ninocity31/Smart-Street-Lighting-LoRa/(commit log)

2026-11-12 Add LED driver design (220 V to 36 V, PFC + LLC)
2026-11-12 Show LED driver schematic in main README
